Hejnovic/irrigation_controller/hardware/Bill of Materials (my setup).xlsx

Item | Part Name | Description / Specification | Qty | UoM | Supplier | Supplier P/N | Lead Time (days) | Unit Price | Ext. Cost | Notes
1 | Raspberry Pi Zero | Single-board computer | 1 | pcs | Botland | RPI-08330 | 3 | 69.9 | 69.9
2 | SD Card | Memory | 1 | pcs | Botland | KAP-02123 | 3 | 18 | 18
3 | Relays Module | Switching equipment | 1 | pcs | Botland | MOD-02357 | 3 | 36.9 | 36.9
4 | Female-female cables | Wiring | 1 | packs | Botland | JUS-19948 | 3 | 4.99 | 4.99
5 | Female-male cables | Wiring | 1 | packs | Botland | JUS-19949 | 3 | 5.4 | 5.4
6 | Male-male cables | Wiring | 1 | packs | Botland | JUS-19622 | 3 | 6.5 | 6.5
7 | ABS hermetic box | Housing | 1 | pcs | Speckable | 71.0638 | 5 | 68.57 | 68.57
8 | PG11 hermetic connector | Connector | 10 | pcs | Speckable | 70.0616 | 5 | 1.88 | 18.8
9 | Surface-mounted distribution board | Housing | 1 | pcs | Speckable | 73.2403 | 5 | 35 | 35
10 | Modular contactor EZCT-20-20-230 | Power relay | 1 | pcs | Kaczmarek electric | 2050968 | 3 | 82.11 | 82.11
11 | Transformer TRM-24 | Power transformer | 1 | pcs | Kaczmarek electric | 1095783 | 3 | 91.87 | 91.87
12 | Modular isolator switch SBN225 Hager | Isolator switch | 1 | pcs | Kaczmarek electric | 1039102 | 3 | 65.18 | 65.18 | Overcurrent protection provided by home installation
13 | YKY 3x2.5mm2 wire | Wiring | 15 | m | Speckable | 02.0143 | 5 | 6.15 | 92.25 | Can put them in the ground to connect pump
14 | M2.5 standoffs with screws and nuts | Mount gear | 1 | packs | Allegro | 17151927517 | 2 | 43.9 | 43.9
15 | 5V/2.5A power adapter | Power adapter | 1 | pcs | Botland | SHR-14515 | 3 | 23.9 | 23.9 | Raspberry Pi needs stable 5V to not do micro restarts
16 | JZ-500 signal cable 7x1mm2 | Signal wiring | 8 | m | Speckable | 03.0408 | 5 | 10.22 | 81.76 | Additional wire in case of fault
17 | 5 Hunter PGV electrovalves + filter | Controllable valves | 1 | packs | Allegro | 17178203919 | 2 | 589.99 | 589.99 | This does not include cost of irrigation equipment and pipes
