Hejnovic/irrigation_controller/hardware/electrical/kicad/schema.pdf

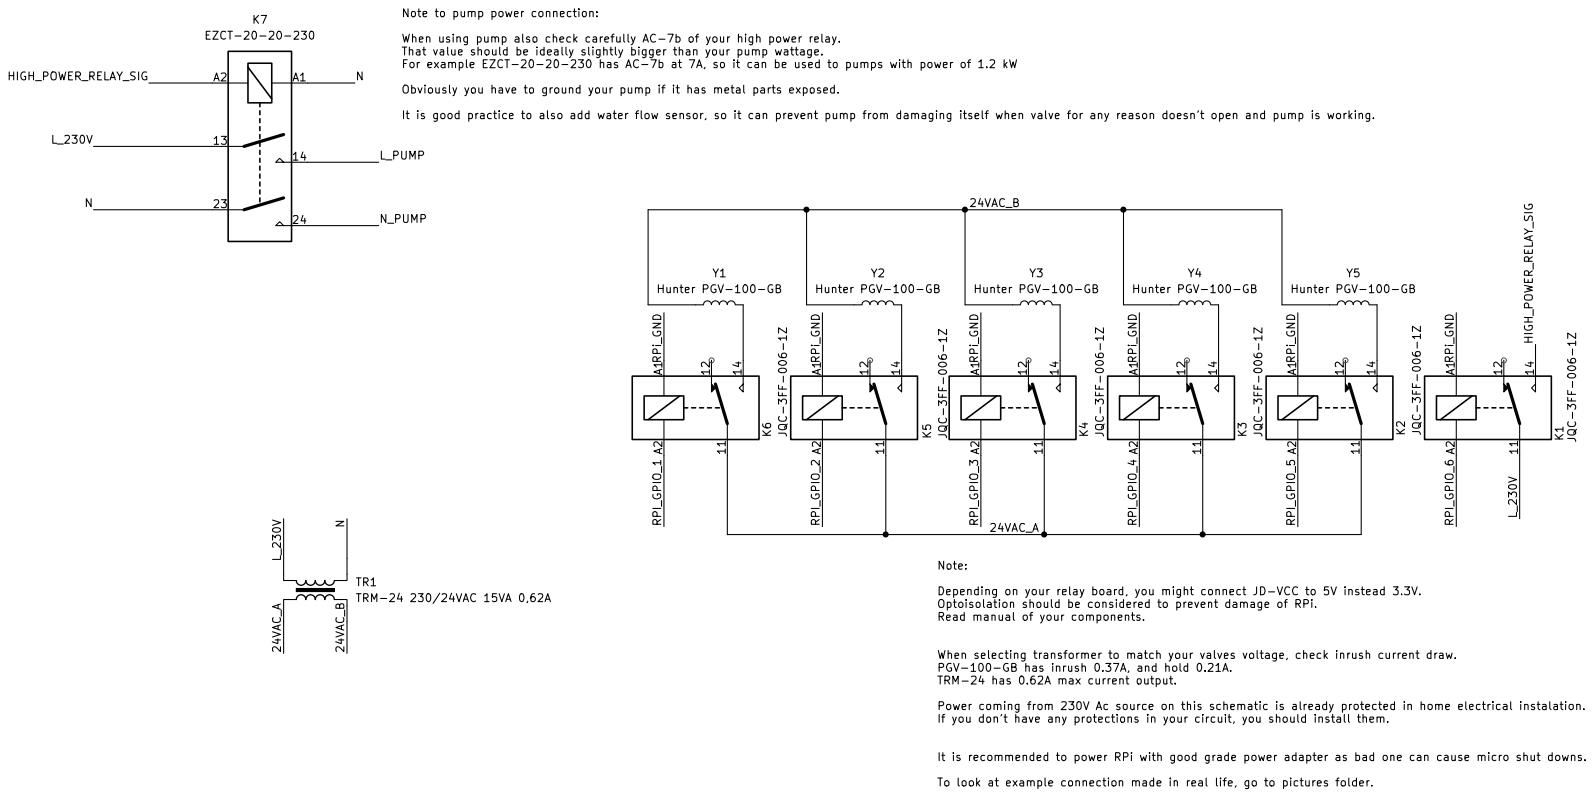
[picture p1: page 1]
