Hejnovic/irrigation_controller/hardware/electrical/kicad/electrical.kicad_sch

## KiCad design hardware/electrical/kicad/electrical.kicad_sch (2026-09-27)

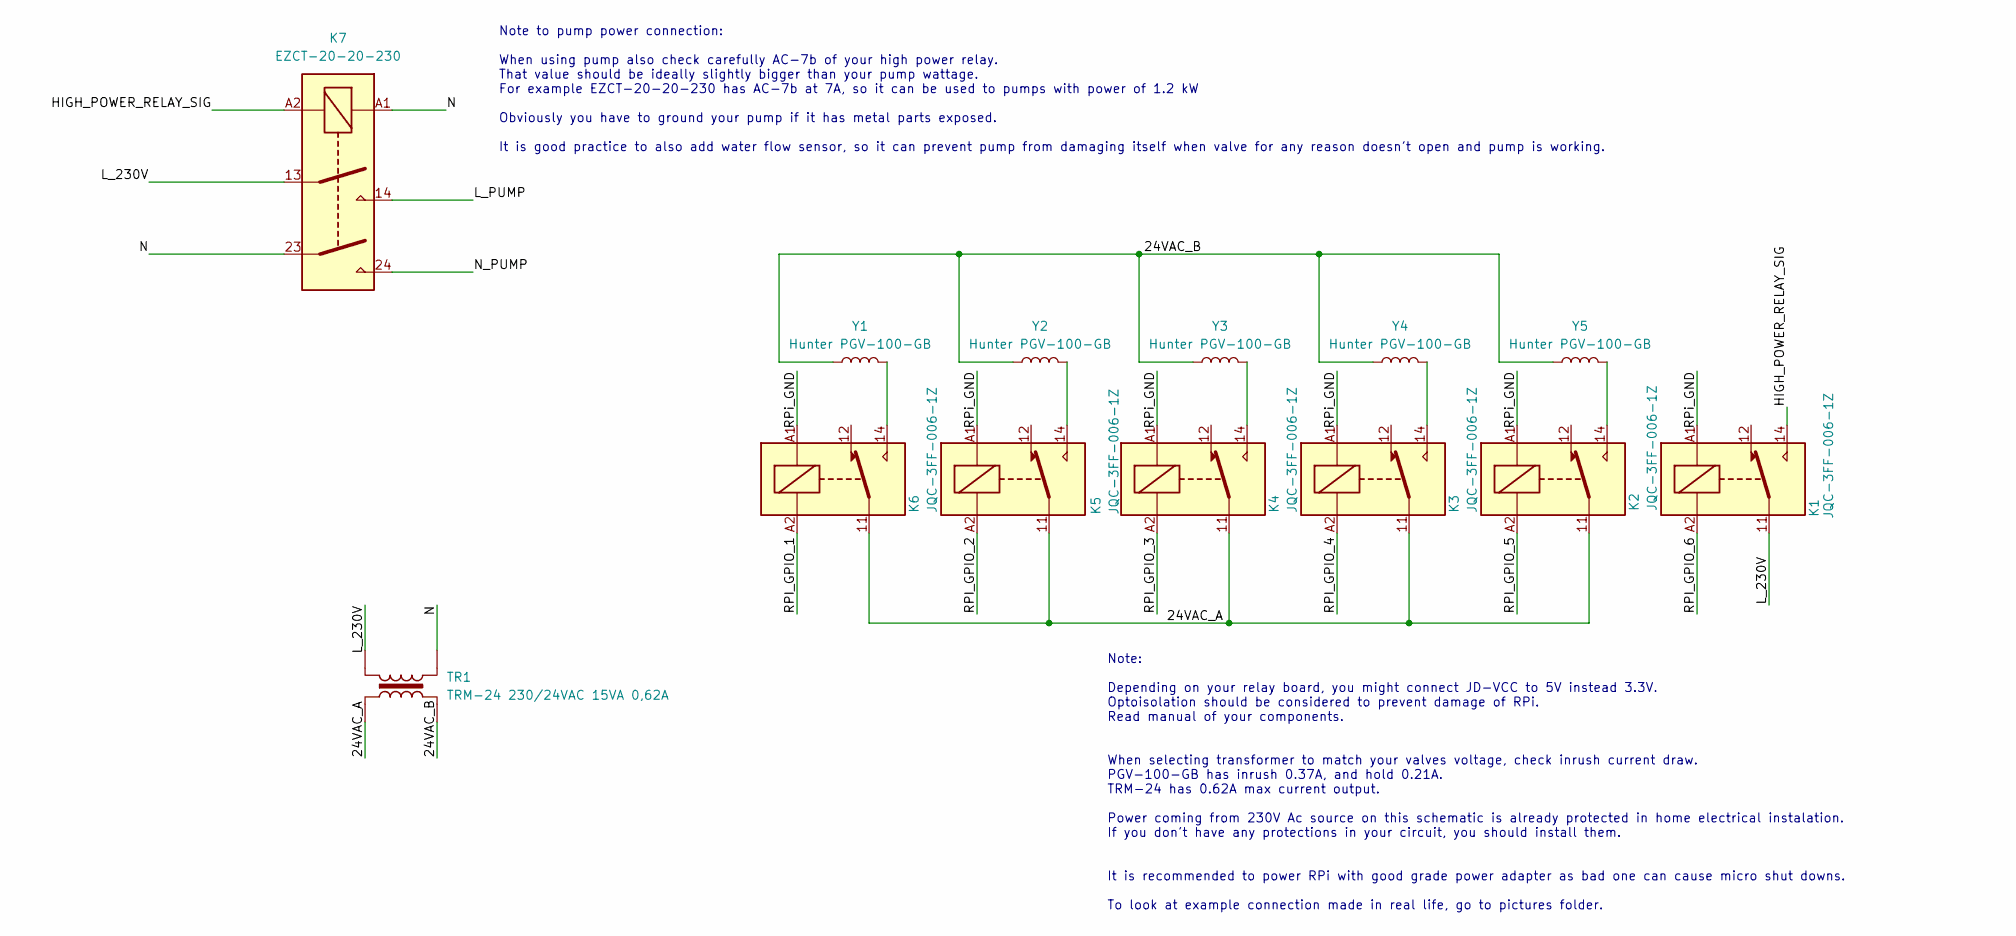
[picture p2: schematic electrical.kicad_sch]

Parts:
K1, K2, K3, K4, K5, K6: JQC-3FF-006-1Z; Relay_SPDT_Hongfa_JQC-3FF_0XX-1Z
K7: EZCT-20-20-230
TR1: TRM-24 230/24VAC 15VA 0,62A
Y1, Y2, Y3, Y4, Y5: Hunter PGV-100-GB

Connections:
24VAC_A: K2.11, K3.11, K4.11, K5.11, K6.11, TR1.1
24VAC_B: TR1.2, Y1.1, Y2.1, Y3.1, Y4.1, Y5.1
HIGH_POWER_RELAY_SIG: K1.14, K7.A2
L_230V: K1.11, K7.13, TR1.4
L_PUMP: K7.14
N: K7.23, K7.A1, TR1.3
N_PUMP: K7.24
unnamed: K2.14, Y5.2
unnamed: K3.14, Y4.2
unnamed: K4.14, Y3.2
unnamed: K5.14, Y2.2
unnamed: K6.14, Y1.2
RPI_GPIO_1: K6.A2
RPI_GPIO_2: K5.A2
RPI_GPIO_3: K4.A2
RPI_GPIO_4: K3.A2
RPI_GPIO_5: K2.A2
RPI_GPIO_6: K1.A2
RPi_GND: K1.A1, K2.A1, K3.A1, K4.A1, K5.A1, K6.A1

Notes on the sheet:
Note to pump power connection: When using pump also check carefully AC-7b of your high power relay. That value should be ideally slightly bigger than your pump wattage. For example EZCT-20-20-230 has AC-7b at 7A, so it can be used to pumps with power of 1.2 kW Obviously you have to ground your pump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
Note: Depending on your relay board, you might connect JD-VCC to 5V instead 3.3V. Optoisolation should be considered to prevent damage of RPi. Read manual of your components. When selecting transformer to match your valves voltage, check inrush current draw. PGV-100-GB has inrush 0.37A, and hold 0.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
