Hejnovic/irrigation_controller/src/core/gpio_controller.py

import gpiod
from gpiod.line import Direction, Value
from ..utils.schedule_entry import ScheduleEntry
from collections.abc import Callable
from ..protocols.scheduler_protocol import SchedulerProtocol
from ..protocols.time_manager_protocol import TimeManagerProtocol
from ..protocols.dashboard_updater_protocol import DashboardUpdaterProtocol
from ..utils.enums import IrrigationState
import logging

logger = logging.getLogger(__name__)

class GPIOController:
    def __init__(self, gpio_builder, chip = "/dev/gpiochip0", consumer="irrigation_controller"):
        self._daily_schedule:ScheduleEntry =  ScheduleEntry(start_time=None,sections=[])
        self._pin_mapping: dict[str,int] = gpio_builder.get_name_map()
        self._chosen_section: str | None = None
        self._time_manager: TimeManagerProtocol | None = None
        self._scheduler: SchedulerProtocol | None = None
        self._dashboard_updater: DashboardUpdaterProtocol | None  = None
        self._irrigation_state = IrrigationState.IDLE
        self._sections_to_irrigate: list[str] = []
        self._current_section: str | None = None
        self._time_end = None
        self._start_time = None
        self._callback_on_stop_device: list[Callable] = []
        self._config = gpio_builder.get_line_config()
        self._gpio = gpiod.request_lines(
            chip,
            consumer=consumer,
            config=self._config
        )
        logger.info(f"GPIO lines requested: {self._pin_mapping}")

    def set_time_manager(self, time_manager: TimeManagerProtocol):
        if time_manager is None:
            logger.error("Cannot set None as time manager")
            return
        if self._time_manager is not None:
            logger.error("Time manager already set for GPIOController")
            return
        self._time_manager = time_manager
        self._time_manager.set_callback_on_day_change(self.set_daily_schedule)
        self._time_manager.set_callback_on_minute_change(self.check_if_should_start_irrigation)
        self._time_manager.set_callback_on_minute_change(self.check_if_should_switch_section)
        logger.info("Time manager set for GPIOController")

    def set_scheduler(self, scheduler: SchedulerProtocol):
        if scheduler is None:
            logger.error("Cannot set None as scheduler")
            return
        if self._scheduler is not None:
            logger.error("Scheduler already set for GPIOController")
            return
        self._scheduler = scheduler
        logger.info("Scheduler set for GPIOController")

    def set_dashboard_updater(self, dashboard_updater: DashboardUpdaterProtocol):
        if dashboard_updater is None:
            logger.error("Cannot set None as dashboard updater")
            return
        if self._dashboard_updater is not None:
            logger.error("Dashboard updater already set for GPIOController")
            return
        self._dashboard_updater = dashboard_updater
        logger.info("Dashboard updater set for GPIOController")

    def set_callback_on_stop_device(self, callback:Callable):
        if callback is None:
            logger.warning(f"Cannot set None as callback for stop device")
            return
        if not callable(callback):
            logger.warning(f"Can not set non callable as callback for stop device: {callback}")
            return
        self._callback_on_stop_device.append(callback)
        logger.info(f"Registered stop device callback: {callback.__name__}")

    def set_value(self, name: str, state: bool):
        if state not in [True,False]:
            logger.warning(f"Provided states for pin {name} is invalid")
            return 
        if name not in self._pin_mapping:
            logger.error(f"Unknown pin name: {name}")
            return
        pin = self._pin_mapping[name]
        value = Value.ACTIVE if state else Value.INACTIVE # Might need reversed because of relay module
        self._gpio.set_value(pin, value)
        logger.info(f"Set pin {name} (GPIO {pin}) to {'ACTIVE' if state else 'INACTIVE'}")

    def set_values(self, states: dict[str, bool]):
        for name, state in states.items():
            self.set_value(name,state)

    def get_value(self, name: str) -> bool:
        if name not in self._pin_mapping:
            logger.error(f"Unknown pin name: {name}")
            return False
        pin = self._pin_mapping[name]
        value = self._gpio.get_value(pin)
        logger.info(f"Read pin {name} (GPIO {pin}): {'ACTIVE' if value else 'INACTIVE'}")
        return value == Value.ACTIVE
    
    ## MANUAL
    def run_pump(self): # Manual pump control, mqtt handler
        if self._irrigation_state == IrrigationState.IRRIGATING:
            logger.info("Already running auto irrigation")
            return
        prev_state = self._irrigation_state
        self._irrigation_state = IrrigationState.MANUAL_PUMP if prev_state == IrrigationState.IDLE else IrrigationState.IDLE
        if prev_state != self._irrigation_state:
            self.set_value("pump", not bool(self._irrigation_state)) #.IDLE is 0  
            logger.info(f"{'Started' if IrrigationState.MANUAL_PUMP else 'Stopped'} pump manually")
            self._dashboard_updater.update_active_section(self._irrigation_state)

    def choose_section(self, section_number: int): # Manual section choosing, mqtt handler
        if section_number < 1 or section_number > 5: #Make it dynamic with some json config (just like irrigation plan)
            logger.error(f"Invalid section number: {section_number}")
            return
        self._chosen_section = f"section{section_number}"
        logger.info(f"Chosen section: {self._chosen_section}")

    def start_selected_section(self): # Manual section control, mqtt handler
        if self._irrigation_state ==  IrrigationState.IDLE:
            if self._chosen_section is None or self._chosen_section == []:
                self._chosen_section = "section1" # Default to section1 if no section chosen
            self._irrigation_state = IrrigationState.MANUAL_SECTION
            self.set_value(self._chosen_section, False)
            self.set_value("pump", False)
            logger.info(f"Started irrigation for {self._chosen_section}")
            self._dashboard_updater.update_active_section(self._irrigation_state,section=self._chosen_section)
        elif self._irrigation_state == IrrigationState.MANUAL_SECTION:
            self.stop_device()

    def start_manual_irrigation(self):
        if self._irrigation_state != IrrigationState.IDLE:
            logger.warning("Cannot start manual irrigation: device is already irrigating")
            return
        self._irrigation_state = IrrigationState.IRRIGATING
        self.set_value("pump", False)
        self._start_time = self._time_manager.current_hour_minute
        self._sections_to_irrigate = sorted(k for k in self._pin_mapping.keys() if k.startswith("section"))
        self._switch_to_next_section()
        
    ## MANUAL END
    def stop_device(self):
        all_inactive = { #It is flipped because of relay module, setting pin to ACTIVE actually turns it off
            pin: True for pin in self._config["outputs"].keys()
        }
        self.set_values(all_inactive)
        self._start_time = None
        self._time_end = None
        logger.info("Stopped irrigation and set all pins to INACTIVE")
        self._irrigation_state = IrrigationState.IDLE
        self._dashboard_updater.update_active_section(self._irrigation_state)
        for callback in self._callback_on_stop_device:
                try:
                    callback()
                except Exception as e:
                    logger.error(f"Error in stop device callback: {e}")

    def _switch_to_next_section(self):
        if self._sections_to_irrigate:
            self._current_section = self._sections_to_irrigate.pop(0) # popping 1st element of sorted (guaranteed by scheduler) list - modyfing in place so no need to track of index
            self.set_value(self._current_section, False)
            self._irrigation_state = IrrigationState.IRRIGATING
            logger.info(f"Started irrigation for {self._current_section} - for {self._scheduler.get_irrigation_time(self._current_section)} minute(s)")
            if self._time_end is None:
                irrigation_time = self._scheduler.get_irrigation_time(self._current_section)
                self._time_end = self._time_manager.add_minutes(self._start_time,irrigation_time)
            self._dashboard_updater.update_active_section(self._irrigation_state,section=self._current_section,time_end=self._time_end,time_interval=irrigation_time)
        else:
            self.stop_device()
            logger.info("Irrigation sequence completed for all sections")

    def start_irrigation_auto(self):
        if not self._daily_schedule.sections:
            logger.info("No sections to irrigate, skipping irrigation")
            return
        if self._daily_schedule.sections == ["all"]:
            self._sections_to_irrigate = sorted(k for k in self._pin_mapping.keys() if k.startswith("section")) # If adding some sensor or smth this won't work - workaround maybe sorted(k for k in self._pin_mapping.keys() if k.startswithc("section") - assuming user names sections - sectionX
        else:
            self._sections_to_irrigate = sorted(self._daily_schedule.sections)
        self.set_value("pump", False)
        self._switch_to_next_section()

    def check_if_should_switch_section(self,_):
        if self._irrigation_state != IrrigationState.IRRIGATING:
            return
        current_time = self._time_manager.current_hour_minute 
        if current_time >= self._time_end: # When current time is equal to start time + irrigation time for current section
            self._start_time = self._time_end
            self._time_end = None
            self.set_value(self._current_section, True) # Stop current section
            self._switch_to_next_section()

    def check_if_should_start_irrigation(self,_):
        if self._irrigation_state != IrrigationState.IDLE:
            logger.warning("Cannot start irrigation: device is not in IDLE state")
            return
        if self._daily_schedule is None:
            logger.warning("Daily schedule not set, cannot check irrigation start")
            return
        if self._time_manager is None:
            logger.warning("Time manager not set, cannot check irrigation start")
            return
        if self._daily_schedule.start_time is None or self._daily_schedule.sections == []:
            return
        current_time = self._time_manager.current_hour_minute
        if current_time == self._daily_schedule.start_time: # Whole minute to start irrigation program
            logger.info(f"Starting irrigation sequence at {self._time_manager.current_datetime} - {self._time_manager.current_day_of_week}")
            self._start_time = self._daily_schedule.start_time
            self.start_irrigation_auto()
            
    def set_daily_schedule(self,new_day): 
        temp_schedule = self._scheduler.get_schedule_for_day(new_day)
        if isinstance(temp_schedule,ScheduleEntry):
            self._daily_schedule = temp_schedule
            self._dashboard_updater.update_schedule(temp_schedule)
        else:
            #Put empty schedule with warning
            self._daily_schedule = ScheduleEntry(start_time=None,sections=[])
            logger.warning("Scheduler provided bad data, swapping for empty ScheduleEntry")
        logger.info(f"Received daily schedule: {self._daily_schedule}")

    def cleanup(self):
        if not hasattr(self, '_gpio') or self._gpio is None:
            return
        
        logger.info("Cleaning up GPIO controller")
        try:
            self.stop_device()  # Ensure all devices are stopped before cleanup
            self._gpio.release()
            self._gpio = None
            logger.info("GPIO controller cleaned up")
        except Exception as e:
            logger.error(f"Error during cleanup: {e}")
