Hejnovic/irrigation_controller/src/utils/dashboard_updater.py

import logging
from .enums import IrrigationState, MQTTTopics
from ..protocols.time_manager_protocol import TimeManagerProtocol
from ..protocols.mqtt_manager_protocol import MqttManagerProtocol
from ..protocols.translator_protocol import TranslatorProtocol
from ..utils.schedule_entry import ScheduleEntry
logger = logging.getLogger(__name__)

class DashboardUpdater:

    def __init__(self):
        self._mqtt_manager:MqttManagerProtocol | None = None
        self._time_manager: TimeManagerProtocol | None  = None 
        self._translator: TranslatorProtocol | None = None
        self._name_map: dict[str,int] = {}

    def set_mqtt_manager(self, mqtt_manager):
        if mqtt_manager is None:
            logger.error("Cannot set None as MQTT manager")
            return
        if self._mqtt_manager is not None:
            logger.error("MQTT manager already set for DashboardUpdater")
            return
        self._mqtt_manager = mqtt_manager
        logger.info("MQTT manager set for DashboardUpdater")
        
    def set_time_manager(self, time_manager: TimeManagerProtocol):
        if time_manager is None:
            logger.error("Cannot set None as time manager")
            return
        if self._time_manager is not None:
            logger.error("Time manager already set for DashboardUpdater")
            return
        self._time_manager = time_manager
        self._time_manager.set_callback_on_minute_change(self.update_datetime)
        logger.info("Time manager set for DashboardUpdater")

    def set_translator(self,translator: TranslatorProtocol):
        if translator is None:
            logger.error("Cannot set None as time manager")
            return
        if self._translator is not None:
            logger.error("Time manager already set for DashboardUpdater")
            return
        self._translator = translator
        logger.info("Translator set for DashboardUpdater")
    def set_name_map(self,name_map):
        if name_map is None:
            logger.error("Cannot set None for name_map")
            return
        self._name_map = name_map
        logger.info(f"Recieved new gpio name map: {name_map}")

    def update_datetime(self,_):
        timestamp = self._time_manager.current_datetime
        weekday = self._time_manager.current_day_of_week
        self._mqtt_manager.publish(MQTTTopics.DEVICE_TIME.topic, f"{timestamp} - {weekday}",qos=MQTTTopics.DEVICE_TIME.qos)
        logger.debug("Dashboard updated")

  
    def update_active_section(self, state:IrrigationState,**kwargs):
    #     class IrrigationState(IntEnum):
    #     IDLE = 0
    #     IRRIGATING = 1
    #     MANUAL_PUMP = 2
    #     MANUAL_SECTION = 3
    #     ERROR = 4 
    ## 5 states that have to consider
        match state:
            case IrrigationState.IDLE:   
                self._mqtt_manager.publish(MQTTTopics.ACTIVE_SECTION.topic,self._translator.translate("device_idle"),qos=MQTTTopics.ACTIVE_SECTION.qos)
                self._mqtt_manager.publish(MQTTTopics.TIME_INTERVAL.topic,"",qos=MQTTTopics.TIME_INTERVAL.qos)                        
            
            case IrrigationState.IRRIGATING:
                section = kwargs.get("section",None)
                time_interval = kwargs.get("time_interval", None)
                time_end = kwargs.get("time_end",None)
                self._mqtt_manager.publish(MQTTTopics.ACTIVE_SECTION.topic,self._translator.translate("section_running_auto",section=section[-1]),qos=MQTTTopics.ACTIVE_SECTION.qos)
                self.update_time_interval(time_end=time_end,time_interval=time_interval)

            case IrrigationState.MANUAL_PUMP:
                self._mqtt_manager.publish(MQTTTopics.ACTIVE_SECTION.topic,self._translator.translate("pump_running_manual"),qos=MQTTTopics.ACTIVE_SECTION.qos,)

            case IrrigationState.MANUAL_SECTION:
                section = kwargs.get("section",None)
                self._mqtt_manager.publish(MQTTTopics.ACTIVE_SECTION.topic,self._translator.translate("section_running_manual",section=section[-1]),qos=MQTTTopics.ACTIVE_SECTION.qos)
            
            case IrrigationState.ERROR:
                error = kwargs.get("error",None)
                self._mqtt_manager.publish(MQTTTopics.ACTIVE_SECTION.topic,self._translator.translate("error"),qos=MQTTTopics.ACTIVE_SECTION.qos)
                logger.error(f"Error occured: {error}")

        logger.debug(f"Dashboard updated")

    def update_time_interval(self, **kwargs) -> None:
        time_end = kwargs.get("time_end",None)
        time_interval = kwargs.get("time_interval",None)
        if not time_interval or not time_end:
            self._mqtt_manager.publish(MQTTTopics.TIME_INTERVAL.topic,"",qos=MQTTTopics.TIME_INTERVAL.qos)
        else:
            self._mqtt_manager.publish(MQTTTopics.TIME_INTERVAL.topic,self._translator.translate("time_interval_auto",time_end=time_end,time_interval=time_interval),qos=MQTTTopics.TIME_INTERVAL.qos)
        logger.debug(f"Dashboard updated")

    def update_schedule(self,schedule:ScheduleEntry) -> None:
        start_time = schedule.start_time
        sections = schedule.sections
        #sections are either ["all"], [] or ["section1","section2"] or None
        #start time is string HH:MM example: 05:25
        section_numbers = sorted([int(section.removeprefix("section")) for section in sections if section.startswith("section")])
        if sections == ["all"] and self._name_map:
                section_numbers = [int(name.removeprefix("section")) for name in self._name_map.keys() if name.startswith("section")]
        if start_time not in ["None",None]:  #"None" evaluates to True
            self._mqtt_manager.publish(MQTTTopics.CURRENT_SCHEDULE.topic,self._translator.translate("daily_schedule",start_time=start_time,sections=(",".join(str(section_numbers)))),qos=MQTTTopics.CURRENT_SCHEDULE.qos)
        else: 
            self._mqtt_manager.publish(MQTTTopics.CURRENT_SCHEDULE.topic,self._translator.translate("daily_schedule_empty"),qos=MQTTTopics.CURRENT_SCHEDULE.qos)
        

    def reset_dashboard_buttons(self) -> None:
        self._mqtt_manager.publish(MQTTTopics.START_SECTION.topic, 0,qos=MQTTTopics.START_SECTION.qos)
        self._mqtt_manager.publish(MQTTTopics.RUN_PUMP.topic, 0,qos=MQTTTopics.RUN_PUMP.qos)
        logger.info("Dashboard buttons reset")

    def reset_dashboard_button(self,button) -> None:
        self._mqtt_manager.publish(button,0)
        logger.info(f"Dashboard button: {button} has been reset")
