Hejnovic/irrigation_controller/src/utils/json_loader.py

import json
from pathlib import Path

import logging

logger = logging.getLogger(__name__)


def  load_json_file(file):
    path = Path(file)
    if not path.is_file():
        logger.warning(f"Provided path is not a file - path: {file}")
        return
    with open(path, 'r') as f:
        try:
            data = json.load(f)
            return data 
        except json.JSONDecodeError as e:
            logger.error(f"Provided file is not parsable JSON with {e.msg}, line: {e.lineno}, column: {e.colno}")
            return e
