Hejnovic/irrigation_controller/(commit log)

2026-08-29 Bugfixes and more tests
    [__main__.py, gpio_controller.py, test_gpio_controller.py]
2026-08-30 Additional tests and bug fixes in start manual pump and set daily schedule functions
    [gpio_controller.py, test_gpio_controller.py]
2026-08-31 More tests and fixes in set_value, set_values, set_callback_on_stop_device functions
    [gpio_controller.py, test_gpio_controller.py]
2026-09-01 Add protocols for creating DI objects, few bugfixes and added initial error handling while opening JSON files
    [__main__.py, dashboard_updater.py, dashboard_updater_protocol.py, gpio_controller.py, mqtt_manager.py, mqtt_manager_protocol.py, scheduler.py]
2026-09-05 Rework of MQTT manager (it is actaully manager now), add paho adapter implementation, more tests
    [__main__.py, mqtt_client_protocol.py, mqtt_manager.py, mqtt_manager_protocol.py, test_mqtt_manager.py, test_watchdog.py, watchdog.py]
2026-09-05 Small fixes to main, and breaking one unit test into separate two tests
    [__main__.py, gpio_controller.py, test_mqtt_manager.py]
2026-09-07 Bugfixes in gpio_controller mqtt_manager and paho_mqtt_adapter
    [__main__.py, dashboard_updater.py, gpio_controller.py, mqtt_manager.py, scheduler.py, test_dashboard_updater.py, test_gpio_controller.py]
2026-09-07 Add enums.py and fix all code that was using self.IrrigationState in gpio_controller
    [dashboard_updater.py, enums.py, gpio_controller.py, test_gpio_controller.py, watchdog.py]
2026-09-08 Add mqtt_manager_protocol, rework of dashboard updater - now you provide state and kwargs instead of strings that had to be displayed on frontend
    [__main__.py, dashboard_updater.py, dashboard_updater_protocol.py, gpio_controller.py, mqtt_manager_protocol.py, test_dashboard_updater.py]
2026-09-23 Fix bugs in __main__ that prevented program from loading, fix bug that prevented loading schedule on dashboard
    [__main__.py, dashboard_updater.py, enums.py, gpio_controller.py, json_loader.py, test_dashboard_updater.py, test_enums.py, test_gpio_controller.py]
2026-09-24 Fix bug that never allowed fronted to display daily_schedule_empty translation
    [dashboard_updater.py]
2026-09-25 Add _resolve_enum function that actually maps strings from JSON to actual Enum of gpiod bindings
    [gpiod_config_builder.py]
2026-09-26 Add stop device call after initialization of pins, change stop device method to only work on outputs
2026-09-27 Add hardware folder and electrical schema made in kicad - in pdf and kicad_sch file
    [electrical.kicad_sch]
2026-09-28 Add proper BoM for my specific setup
    [Bill of Materials (my setup).xlsx]
2026-09-29 Change in dashboard updater for dynamic displaying of [all] case, fix bug that would prevent displaying sections above 10
    [__main__.py, dashboard_updater.py]
2026-09-30 Removed stop_device() call in init -> class is not fully initialized before all DI is done, deleted test __exit__ in GPIOController - exit callback is executed by cleanup_manager not class itself. Fi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
    [dashboard_updater.py, gpio_controller.py, test_dashboard_updater.py, test_gpio_controller.py]
